sakurachari/yosino58/docs/buildguide_jp.md

# yosino58 ビルドガイド

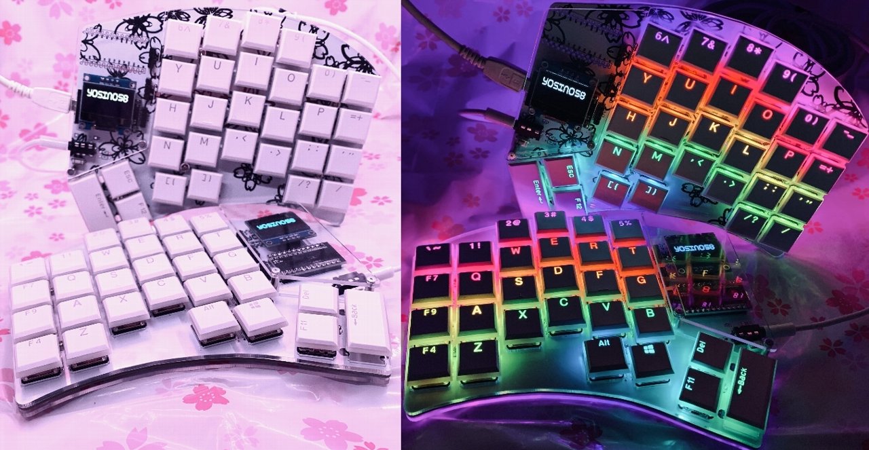
[picture p4: images/0-1.jpg]


## 目次
- [0.事前準備](#0-事前準備)
  - [キットの内容物](#キットの内容物)
  - [キット以外に必要な部品](#キット以外に必要な部品)
  - [オプション品](#オプション品)
  - [必要工具](#必要工具)
- [1.ダイオードのハンダ付け](#1-ダイオードのハンダ付け)
- [Op1.バックライトLEDのハンダ付け](#Op1-バックライトLEDのハンダ付け)
- [2.リセットスイッチ、TRRSジャックのハンダ付け](#2-リセットスイッチTRRSジャックのハンダ付け)
- [Op2.OLEDの取り付け](#Op2-OLEDの取り付け)
- [3.ProMicroのハンダ付け](#3-ProMicroのハンダ付け)
- [Op3.スタビライザーの取り付け](#Op3-スタビライザーの取り付け)
- [4.キースイッチのハンダ付け](#4-キースイッチのハンダ付け)
- [5.LEDテープのハンダ付け](#5-LEDテープのハンダ付け)
- [6.プレートの取り付け](#6-プレートの取り付け)
- [7.ファームウェアの書き込み](#7-QMKファームウェアの書き込み)
  
---

## 0. 事前準備

### キットの内容物

|| 名前 | 数量 | 備考 |
|:---:|---|---:|---|
|1|PCB|2||
|2|トッププレート|2||
|3|ボトムプレート|2||
|4|promicro保護プレート|2||
|5|Pro Micro|2||
|6|表面実装ダイオード|58|＋予備|
|7|TRRSジャック|2||
|8|リセットスイッチ|2||
|9|LEDテープ|3||
|10|M2スペーサー 8mm|10||
|11|M2スペーサー 10mm|4||
|12|M2ねじ 4mm|28||
|13|ゴム足|10||

### キット以外に必要な部品

|| 名前 | 数量 | 備考 |
|:---:|---|---:|---|
|1|キースイッチ|58|CherryMXもしくはKailh Choc|
|2|キーキャップ|58|内2つは2Uの物を推奨|
|3|TRS(3極)ケーブル|1|TRRS(4極)ケーブルでも可|
|4|MicroUSBケーブル|1||

### オプション品

| 名前 | 数量 | 備考 |
|---|---|---|
|2U用 スタビライザー|2|※Kailh Choc用は未対応|
|コンスルー|4|Promicroの着脱が簡単になる<br>[遊舎工房][1]さんで購入できます|
|SK6812MINI|58|バックライト用|
|OLEDディスプレイ|2|ロゴや状態表示が可能になる|
|OLED用ピンソケット|2|OLEDの着脱が簡単になる|
|BLE Micro Pro|2|無線化できるようになる<br>[のぎけす屋][2]さんで購入できます。<br>遊舎工房さん実店舗でも販売されています。|
|BLE用電池基盤|2|[のぎけす屋][2]さんで購入できます。<br>遊舎工房さん実店舗でも販売されています。|

### 必要工具
- 温調ハンダごて
- ハンダ
- ニッパー
- 精密ドライバー
- マスキングテープ ※Kailh Chocの場合あったほうが良い

[1]:https://yushakobo.jp/shop/a01mc-00/
[2]:https://nogikes.booth.pm

---

## 1. ダイオードのハンダ付け
　本キットのPCBはリバーシブルになっています。  
　ビルドガイドではロゴ(yosino58)が表記されている面を表面、桜柄が入っている面を裏面として説明していきます。  
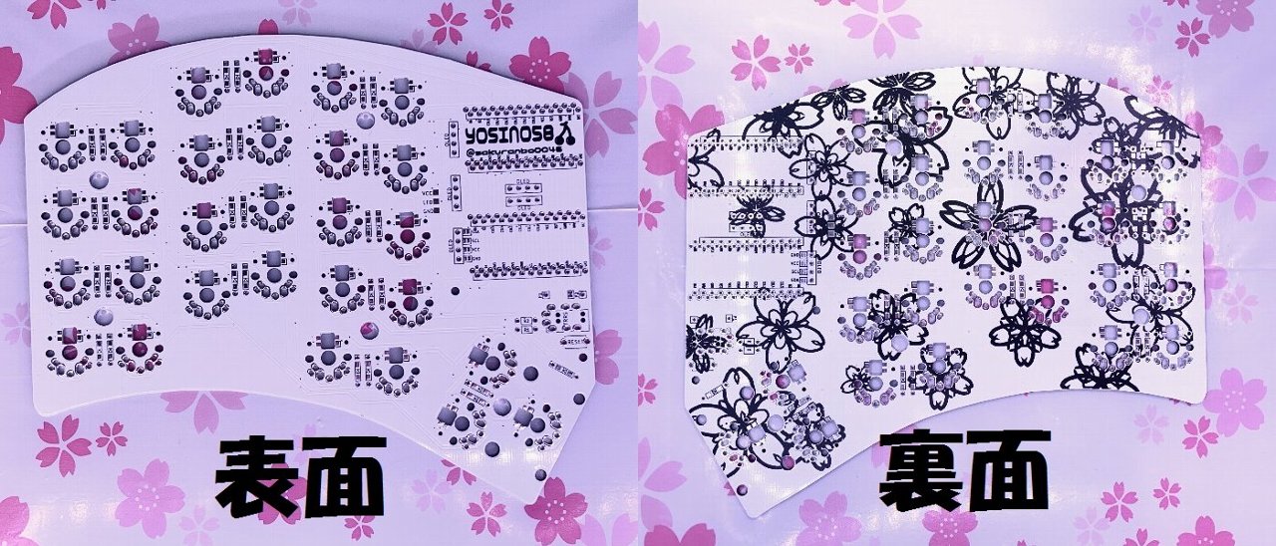
[picture p5: images/1-1.jpg]
  

　以降は左手用で説明します。右手用はPCBを反転して下さい。

　裏面にダイオードを実装していきます。  
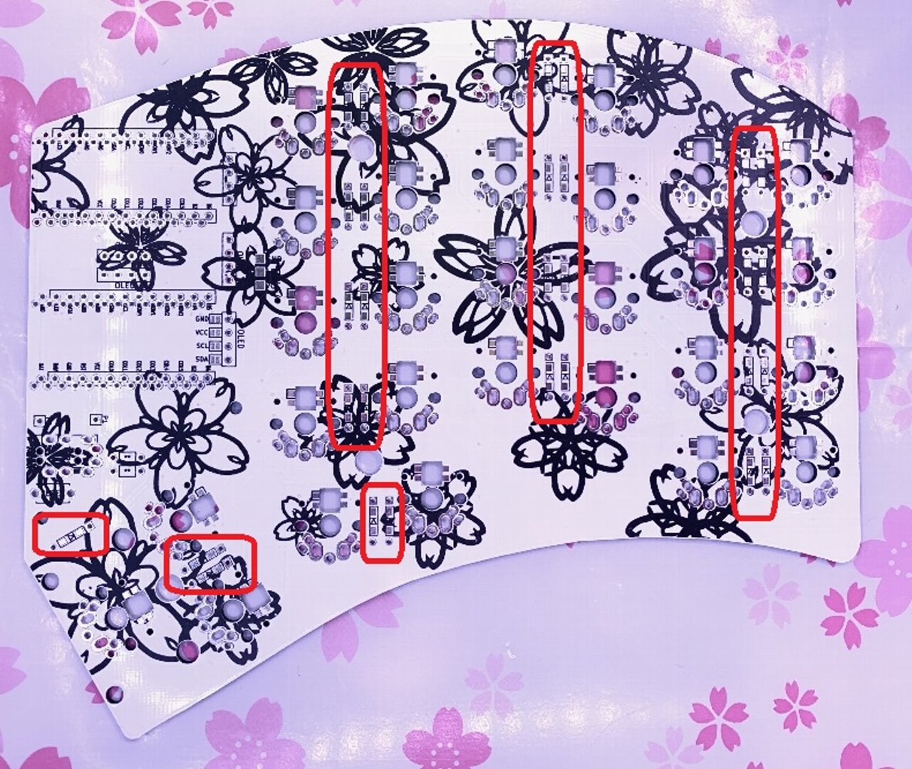
[picture p6: images/1-2.jpg]
  

　ダイオードには向きがあるので注意してください。線が入っている方が上にくるようにハンダ付けしてください。  
　上下両方をハンダ付けしてください。  
　※先に一方のパッドにハンダを付けて温めながらダイオードを付けていくと簡単です。  

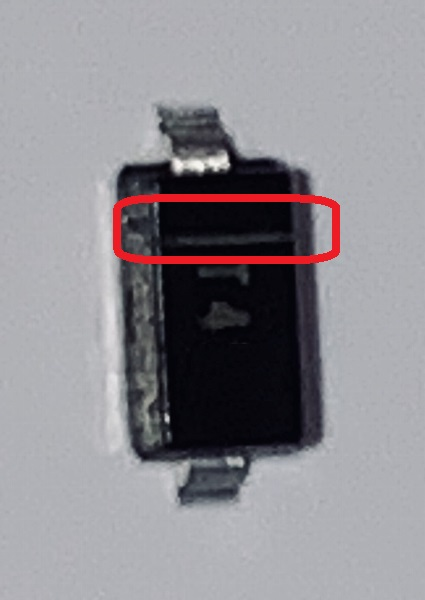
[picture p7: images/1-3.jpg]
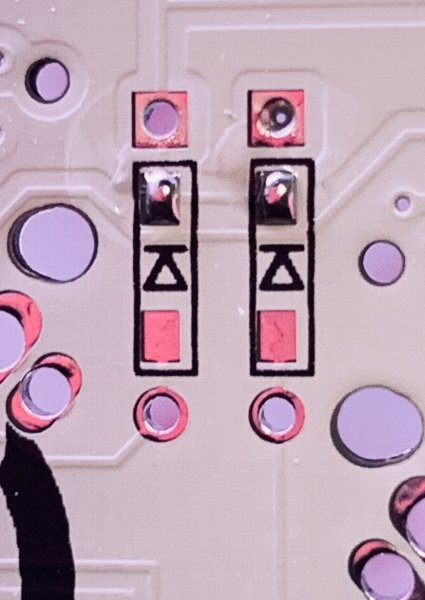
[picture p8: images/1-4.jpg]
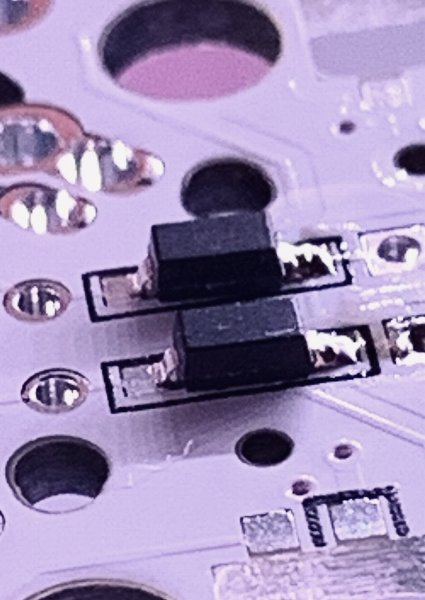
[picture p9: images/1-5.jpg]
||||
|---|---|---|
  
---

## Op1. バックライトLEDのハンダ付け
　バックライトLED用のチップLEDを実装する際には裏面から実装します。  
　チップLEDの一番大きいパッドがPCBの□で囲っているところになるように実装してください。  
　□が見えにくいところがありますが、すべて同じ向きになっていますので見えるところと合わせてください。  
　温調半田ごてを使い、約220℃ではんだ付けします。温度が高いとLEDが壊れますのでご注意ください。  
  
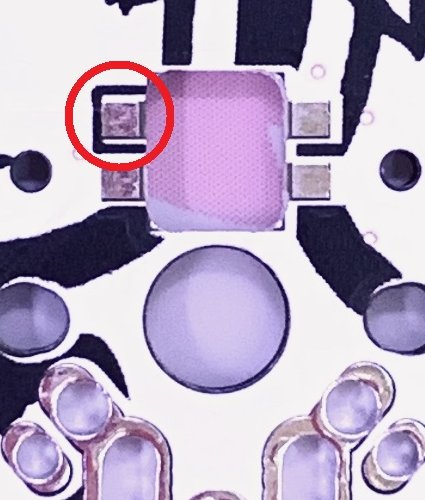
[picture p10: images/Op1-1.jpg]
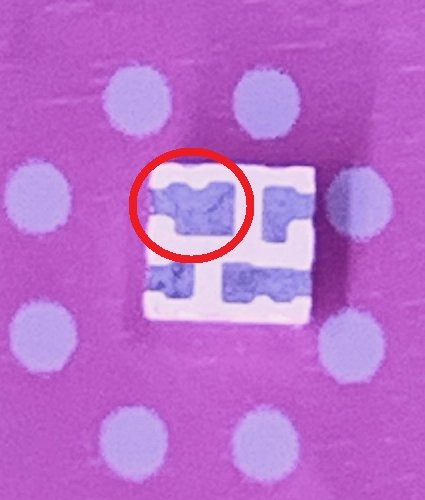
[picture p11: images/Op1-2.jpg]
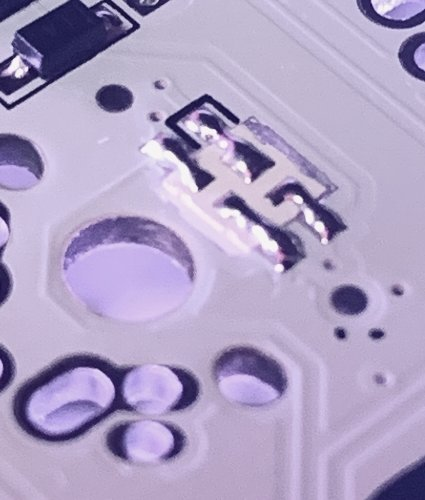
[picture p12: images/Op1-3.jpg]
||||
|---|---|---|

LEDの点灯順番は以下のようになってます。  
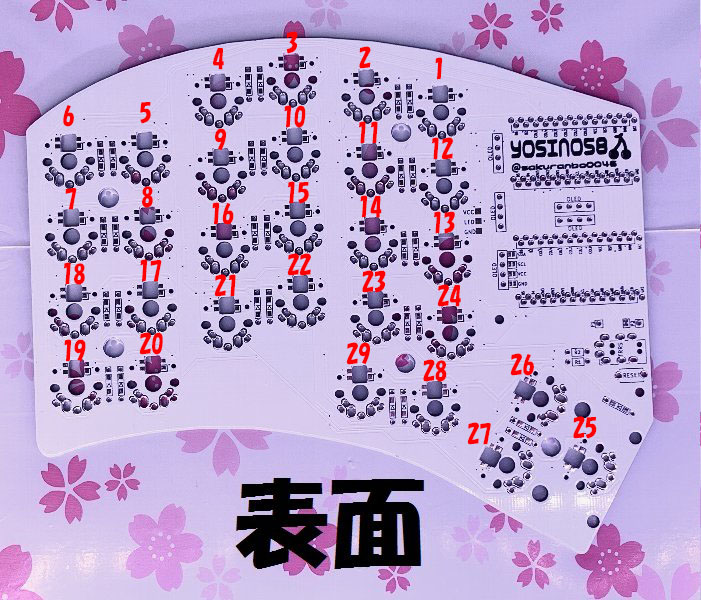
[picture p13: images/Op1-4.jpg]


---

## 2. リセットスイッチ、TRRSジャックのハンダ付け
　表面から実装し、裏面をハンダ付けします。  

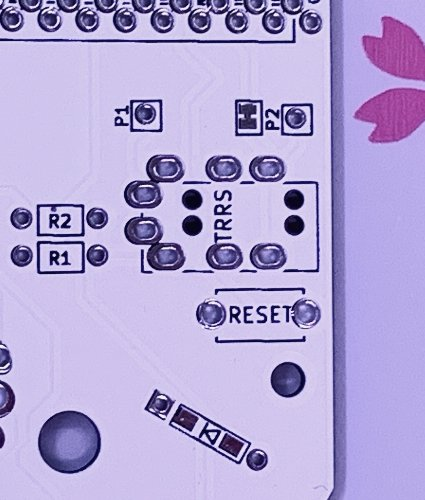
[picture p14: images/2-1.jpg]
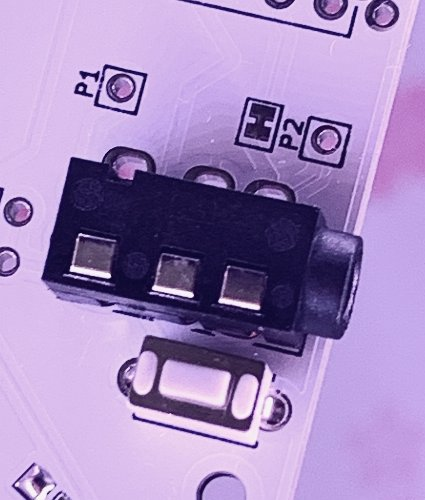
[picture p15: images/2-2.jpg]
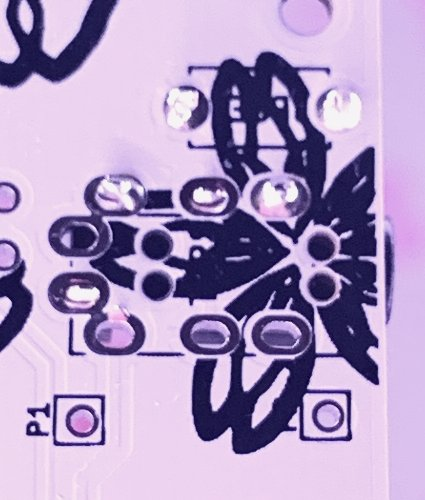
[picture p16: images/2-3.jpg]
||||
|---|---|---|

---

## Op2. OLEDの取り付け
　OLEDディスプレイを取り付ける場合は表面の画像の箇所をジャンパしてください。  
  
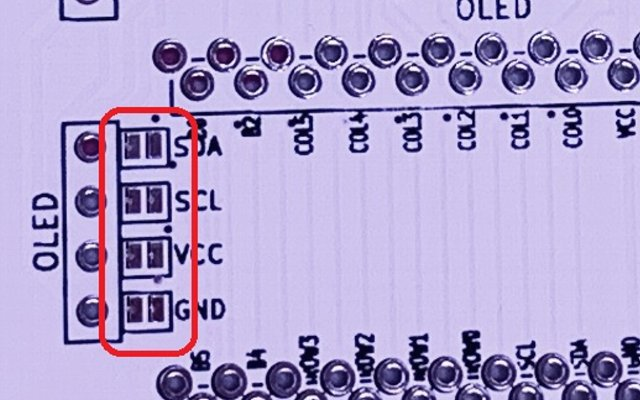
[picture p17: images/Op2-1.jpg]
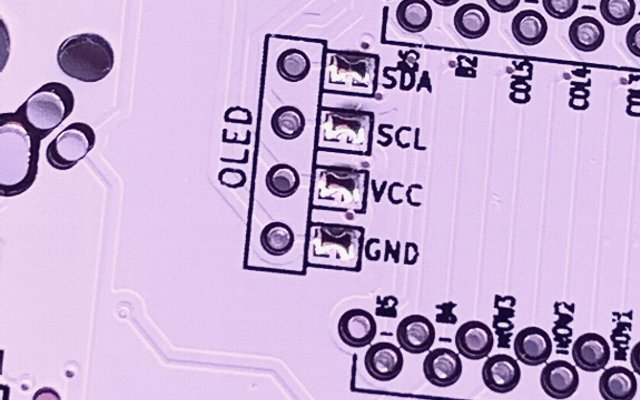
[picture p18: images/Op2-2.jpg]
|||
|---|---|

　OLEDディスプレイを取り付ける為のピンソケットを表面から実装し、裏面をハンダ付けします。  
　OLEDディスプレイを取り付ける場合はOLEDという文字がOLEDのピン側に見えるように取り付けます。  
　取り付け箇所は
　128×64ビットのOLEDは真ん中を起点に上、下  
　128×32ビットのOLEDは上、真ん中、下  のいずれかに取り付けてください。  

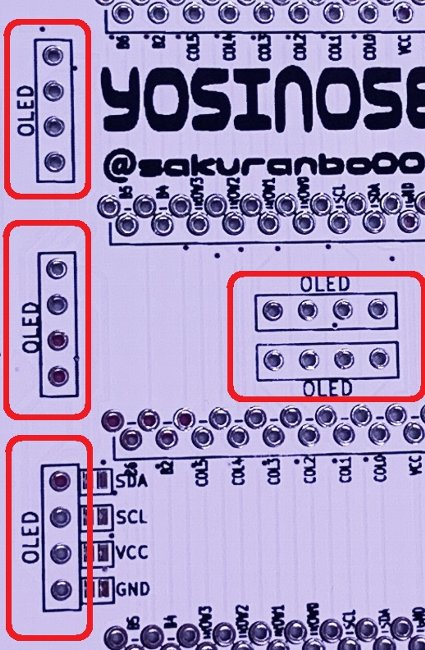
[picture p19: images/Op2-3.jpg]
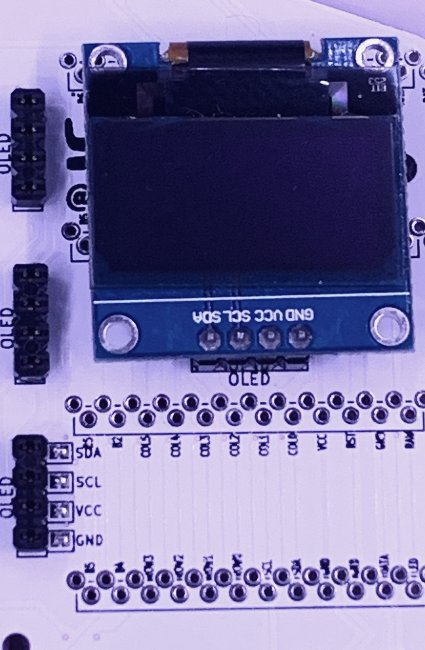
[picture p20: images/Op2-4.jpg]
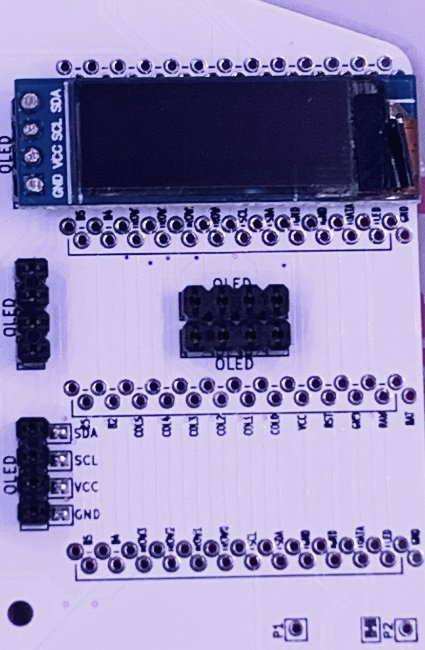
[picture p21: images/Op2-5.jpg]
||||
|---|---|---|

---

## 3. ProMicroのハンダ付け
　ProMicroを上、下いずれかにハンダ付けします。  
　□で囲まれている部分に差し込んでください。またProMicroは部品が実装されている面を下側にしてください。  
　※BLE Micro Pro用に13ピンさせるようになっています。ProMicroの場合一番外側(画像では一番右)は使用しません。  
　※コンスルーを使用する場合はProMicro側をハンダ付けしてください。PCB側のハンダは不要、差し込むだけでOKです。  

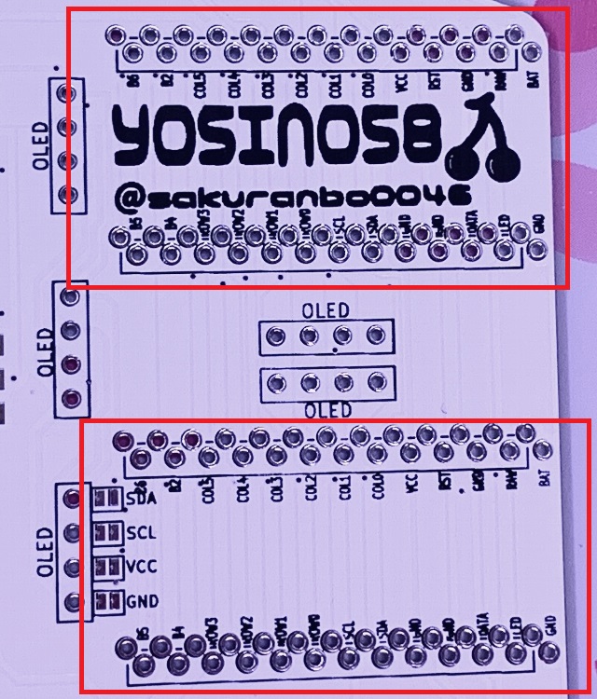
[picture p22: images/3-1.jpg]
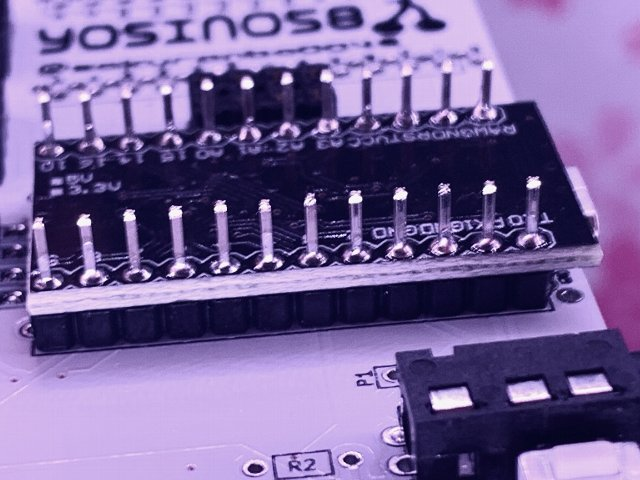
[picture p23: images/3-2.jpg]
|||
|---|---|

　ProMicro側をハンダ付けし、裏返し裏面に出ているピンもハンダ付けします。  
　飛び出しているピンはニッパー等で切り落としてください。

---
## Op3. スタビライザーの取り付け
　スタビライザーを取り付ける場合は画像のように表面に取り付けてください。  
　しっかりと装着してください。※私は少し浮いていてアクリルを割りました。

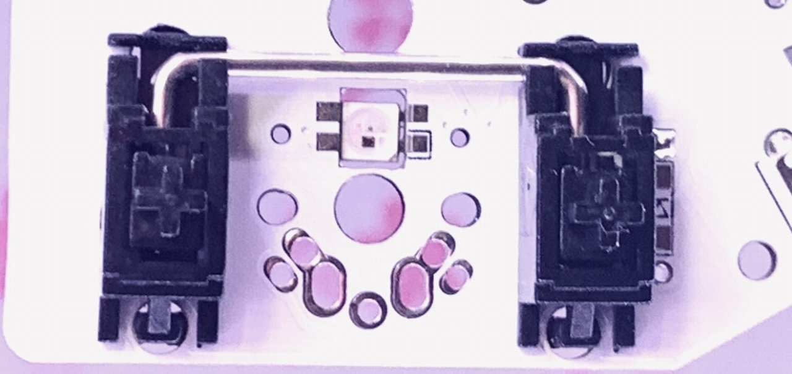
[picture p24: images/Op3-1.jpg]
  
  
---

## 4. キースイッチのハンダ付け
　トッププレート、ボトムプレート、Promicro保護プレートにはフィルムが貼られていますので剥がしてください。  
　トッププレートにスイッチをはめ、表面に取り付けます。  
　取り付け後裏面のスイッチから出ているピンをハンダ付けします。  
　Kailh Chocの場合は裏返す前にマスキングテープ等で固定すると良いです。

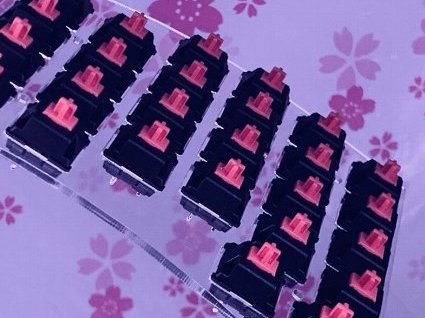
[picture p25: images/4-1.jpg]
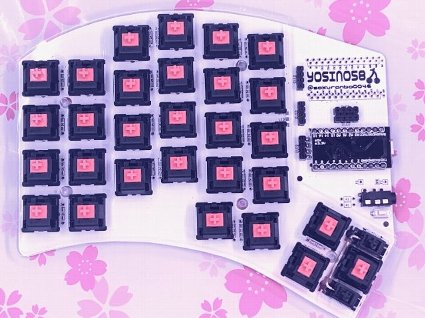
[picture p26: images/4-2.jpg]
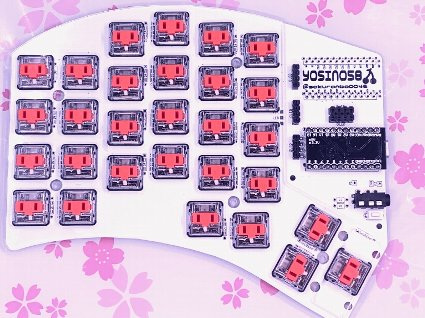
[picture p27: images/4-3.jpg]
||||
|---|---|---|

---

## 5. LEDテープのハンダ付け
　LEDテープを裏面にハンダ付けします。  
　LEDテープの「Din」と書かれているほうをパッドにハンダ付けしてください。  
  
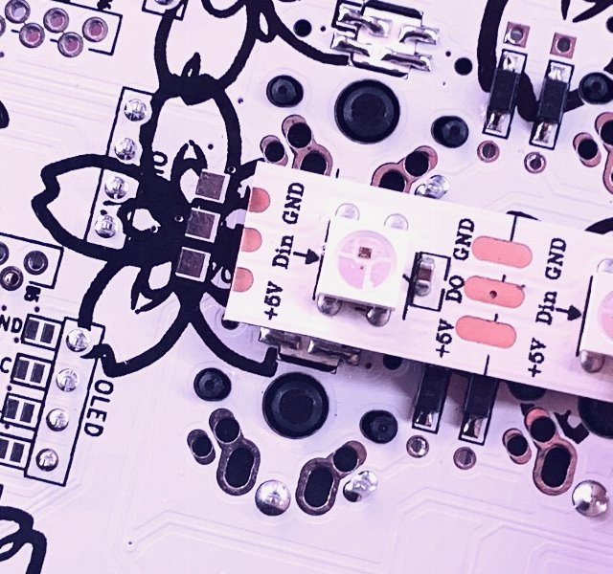
[picture p28: images/5-1.jpg]
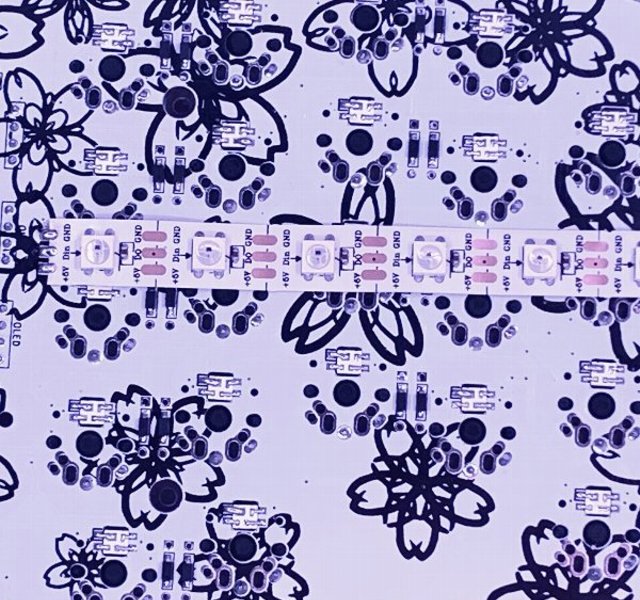
[picture p29: images/5-2.jpg]
|||
|---|---|

---

## 6. プレートの取り付け
　8mmのスペーサーを画像の箇所に取り付けます。  
　表面のトッププレートからネジを差し込みスペーサーを固定します。
  
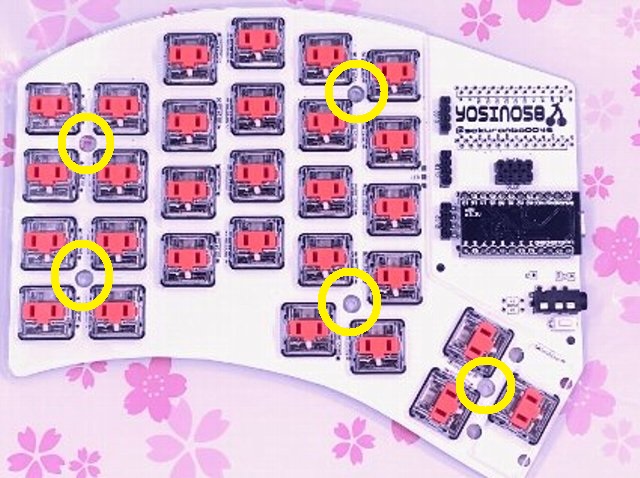
[picture p30: images/6-1.jpg]
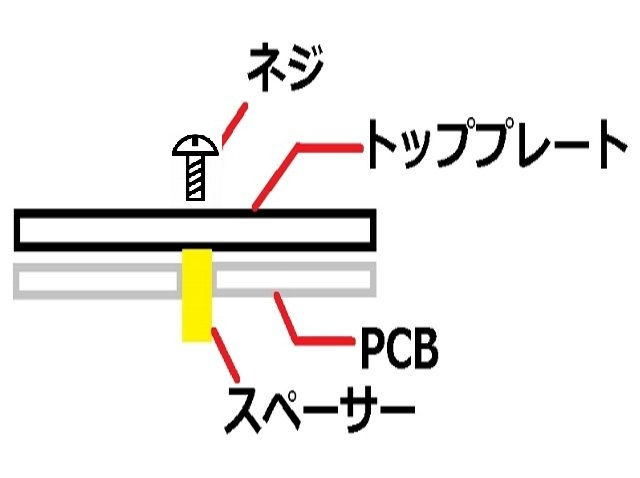
[picture p31: images/6-2.jpg]
|||
|---|---|

　ProMicro保護プレート用のスペーサーを画像の箇所に取り付けます。  
　裏面からネジを差し込み表面にスペーサーを固定します。

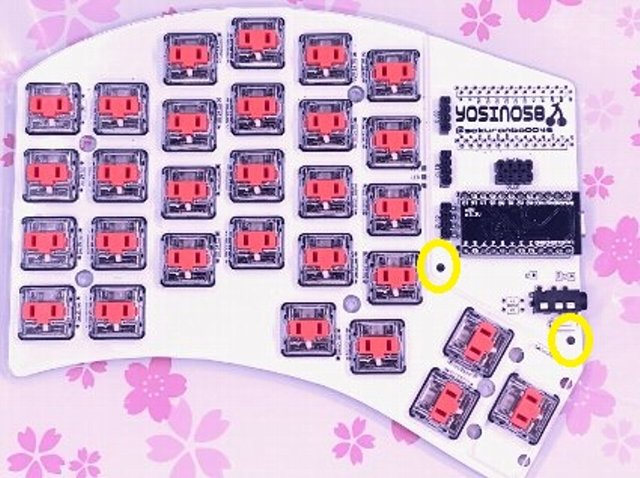
[picture p32: images/6-3.jpg]
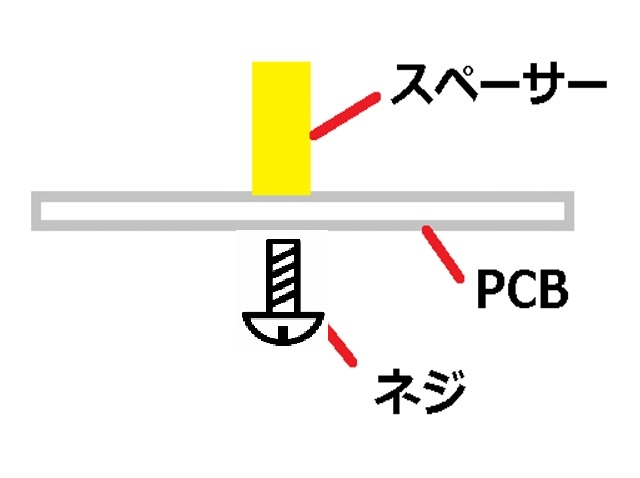
[picture p33: images/6-4.jpg]
|||
|---|---|

　表面からProMicro保護用のプレートをネジで固定します。  
　裏面からボトムプレートを同様にネジで固定します。
  
---

## 7. QMKファームウェアの書き込み

QMKのビルド環境の構築などは[公式ドキュメント][7-1]を参考にするか、他の方のビルドガイドなどを参考にしてください。

qmkファームウェアは[公式][7-2]からGETしてください。  

yosino58のデフォルトキーマップを書き込むにはqmk_firmwareのフォルダ階層で以下を実行します。  

```
make yosino58:default:avrdude 
```

Detecting USB port, reset your controller now... と表示されたらキーボード上のリセットボタンを押すと書き込みが始まります。  
もう片方のキーボードにも同じように書き込みを行って下さい。

### キーマップのカスタマイズ
/keymaps/default/を参考にkeymap.cを編集します。
キーコードなどは[ここ][7-3]を参考にしてください。

[7-1]:https://docs.qmk.fm/#/
[7-2]:https://github.com/qmk/qmk_firmware/
[7-3]:https://github.com/qmk/qmk_firmware/blob/master/docs/keycodes.md

---
