sakurachari/yosino58/(commit log)

2019-03-21 ビルドガイド作成
2019-03-22 ケース作成
2019-03-22 pcb作成
    [yosino58.kicad_pcb, yosino58.sch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]
2019-03-26 ビルドガイド作成
2019-04-04 SK6812MINIの外形修正
    [yosino58.sch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]
2019-04-12 qmk部分修正
2019-04-23 スイッチ取付の説明修正
2019-04-28 LED点灯順追加
2019-05-14 ソケット版追加
    [_yosino58_cherry.kicad_pcb, yosino58_cherry.kicad_pcb, yosino58_cherry.sch]
2019-05-22 基本外形修正
    [yosino58_chocolate.kicad_pcb]
2019-05-22 Logo画像追加
